luxeria/e-wall/README.md

e-wall
======

Steuerung e-wall

Die E-Wall ist eine Wand bestehend aus 12 Mainboards. 
Wenn Personen vor der Wand durchlaufen, soll darauf reagiert werden. 

Die Messung der Distanz erfolgt dabei über Ultraschall. 
Die Lüfter und LEDs werden mit einem Schieberegister angesteuert.
