luxeria/e-wall/doc/firmware.tex

% coding:utf-8

%E-Wall
%Copyright (C) 2013, Daniel Winz, Ervin Mazlagic

%This program is free software; you can redistribute it and/or
%modify it under the terms of the GNU General Public License
%as published by the Free Software Foundation; either version 2
%of the License, or (at your option) any later version.

%This program is distributed in the hope that it will be useful,
%but WITHOUT ANY WARRANTY; without even the implied warranty of
%MERCHANTABILITY or FITNESS FOR A PARTICULAR PURPOSE.  See the
%GNU General Public License for more details.
%----------------------------------------

\section{Firmware}

\subsection{Konzept}
Der Ultraschallsensor wird in regelmässigen Abständen ausgelesen. Die 
Zeitmessung erfolgt dabei durch einen Timer. Anschliessend werden die 
Ausgänge entsprechend der gemessenen Distanz gesetzt. Dabei werden 
grundsätzlich bei abnehmender Distanz mehr Ausgänge gesetzt. Die 
Ansteuerung der Schieberegister erfolgt dabei durch das SPI Modul. Nach der 
Übertragung werden die Schieberegister gesetzt. Anschliessend folgt die 
nächste Distanzmessung.
