luxeria/e-wall/hardware/LaunchPad_Standard20.png

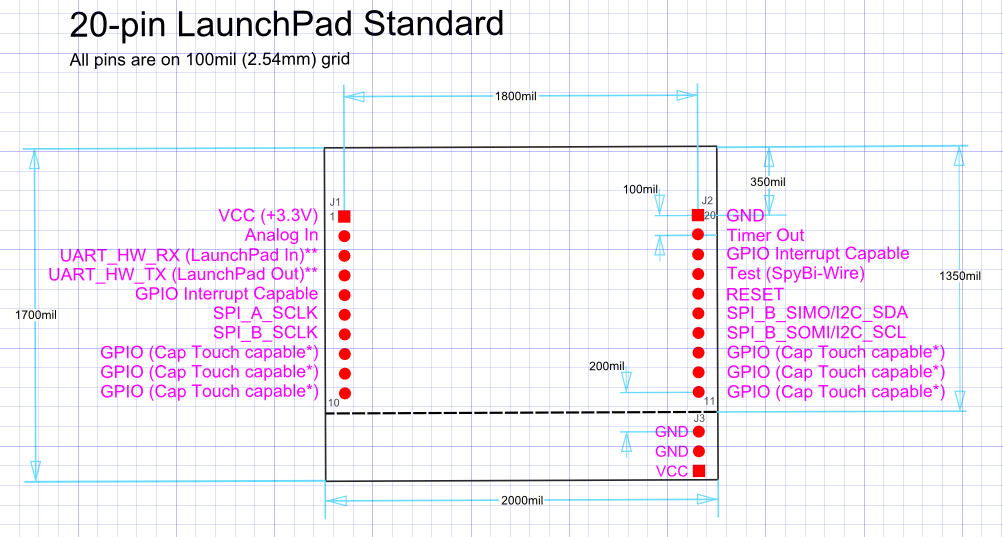
hardware/LaunchPad_Standard20.png
