luxeria/e-wall/hardware/e-wall-smd.brd

## EAGLE design hardware/e-wall-smd.brd (2015-08-02)

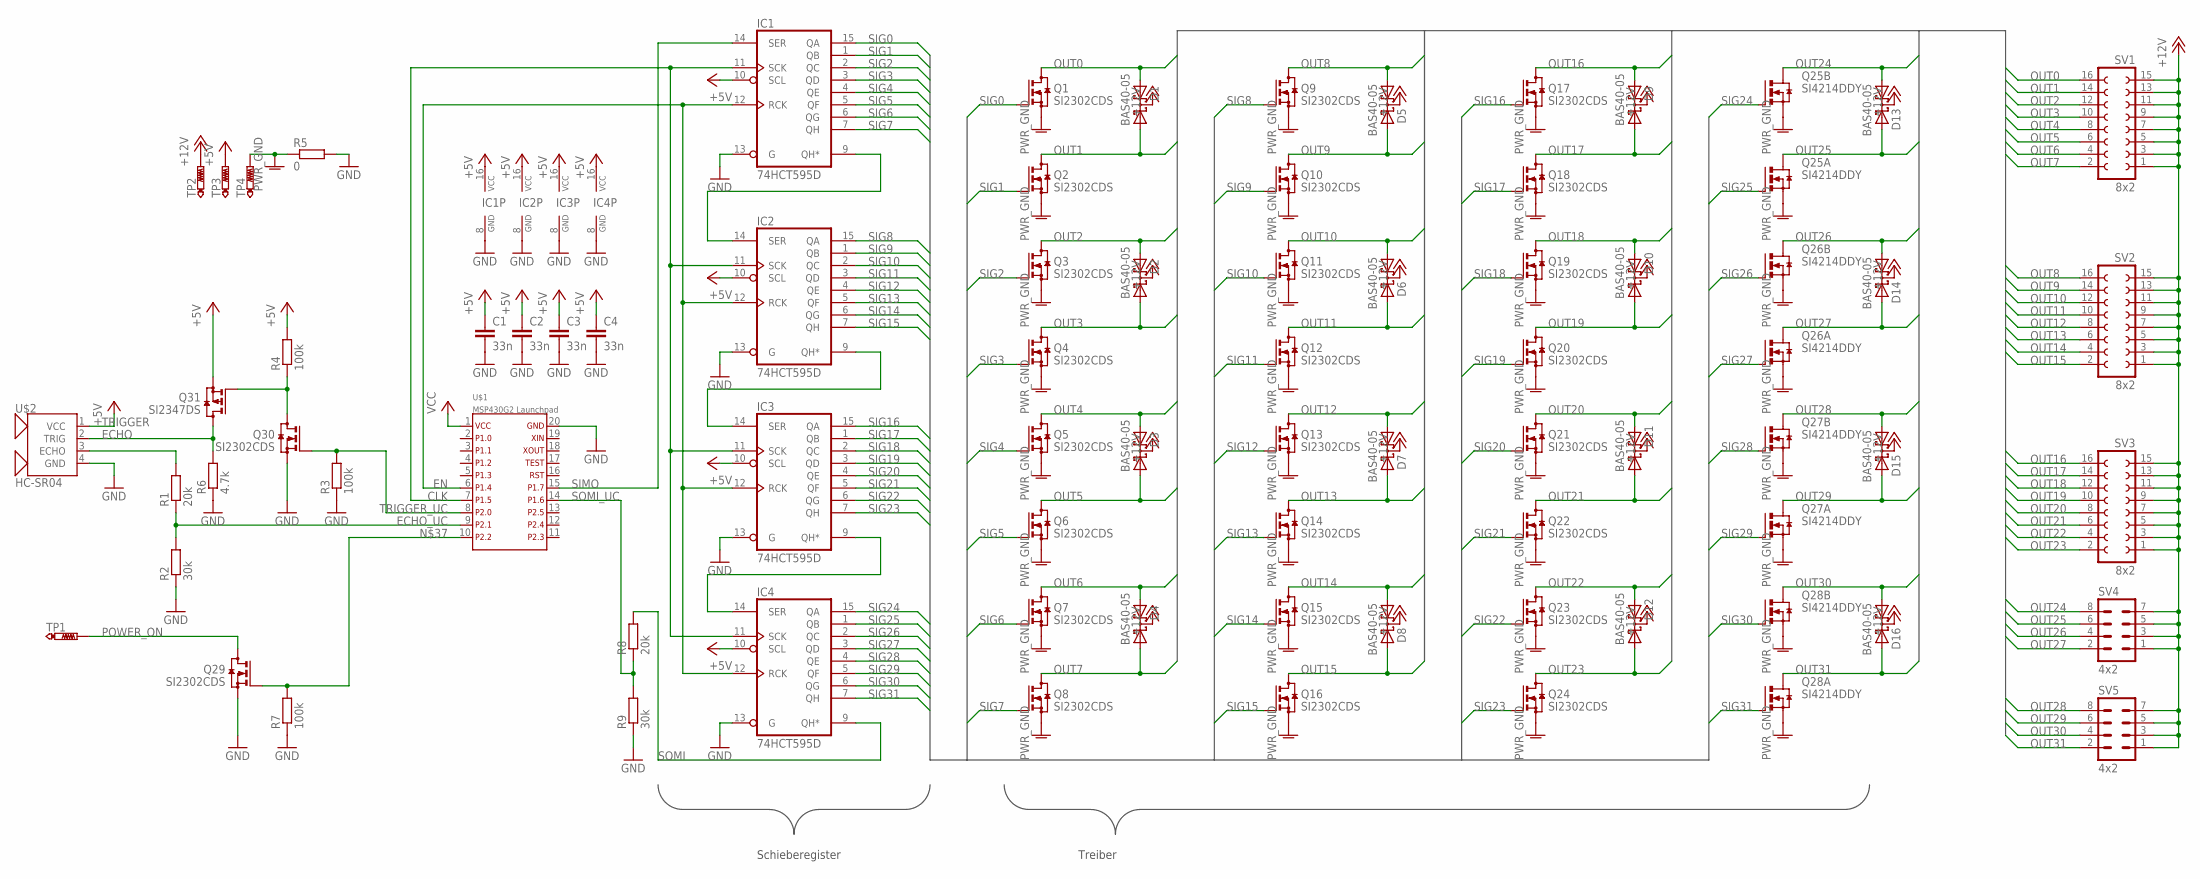
[picture p2: schematic e-wall-smd.sch]

Parts:
C1, C2, C3, C4: 33n; C1206
D1, D2, D3, D4, D5, D6, D7, D8, D9, D10, D11, D12, D13, D14, D15, D16: BAS40-05; SOT23
IC1, IC2, IC3, IC4: 74HCT595D; SO16
Q1, Q2, Q3, Q4, Q5, Q6, Q7, Q8, Q9, Q10, Q11, Q12, Q13, Q14, Q15, Q16, Q17, Q18, Q19, Q20, Q21, Q22, Q23, Q24, Q29, Q30: SI2302CDS; SOT23
Q25, Q26, Q27, Q28: SI4214DDY; SO-08
Q31: SI2347DS; SOT23
R1, R8: 20k; R1206
R2, R9: 30k; R1206
R3, R4, R7: 100k; R1206
R5: 0; R1206
R6: 4.7k; R1206
SV1, SV2, SV3: 8x2; FE08-2
SV4, SV5: 4x2; MA04-2
TP1, TP2, TP3, TP4: PTR1PAD1-20; P1-20
U$1: MSP430G2 Launchpad; MSP430LAUNCHPAD_BASIC
U$2: HC-SR04

Connections:
+5V: C1.1, C2.1, C3.1, C4.1, IC1.10 (SCL), IC1.16 (VCC), IC2.10 (SCL), IC2.16 (VCC), IC3.10 (SCL), IC3.16 (VCC), IC4.10 (SCL), IC4.16 (VCC), Q31.2 (S), R4.2, TP3.TP, U$2.1 (VCC)
+12V: D1.3 (C), D2.3 (C), D3.3 (C), D4.3 (C), D5.3 (C), D6.3 (C), D7.3 (C), D8.3 (C), D9.3 (C), D10.3 (C), D11.3 (C), D12.3 (C), D13.3 (C), D14.3 (C), D15.3 (C), D16.3 (C), SV1.1, SV1.3, SV1.5, SV1.7, SV1.9, SV1.11, SV1.13, SV1.15, SV2.1, SV2.3, SV2.5, SV2.7, SV2.9, SV2.11, SV2.13, SV2.15, SV3.1, SV3.3, SV3.5, SV3.7, SV3.9, SV3.11, SV3.13, SV3.15, SV4.1, SV4.3, SV4.5, SV4.7, SV5.1, SV5.3, SV5.5, SV5.7, TP2.TP
CLK: IC1.11 (SCK), IC2.11 (SCK), IC3.11 (SCK), IC4.11 (SCK), U$1.7
ECHO: R1.2, U$2.3 (ECHO)
ECHO_UC: R1.1, R2.2, U$1.9
EN: IC1.12 (RCK), IC2.12 (RCK), IC3.12 (RCK), IC4.12 (RCK), U$1.6
GND: C1.2, C2.2, C3.2, C4.2, IC1.8 (GND), IC1.13 (G), IC2.8 (GND), IC2.13 (G), IC3.8 (GND), IC3.13 (G), IC4.8 (GND), IC4.13 (G), Q29.2 (S), Q30.2 (S), R2.1, R3.1, R5.2, R6.1, R7.1, R9.1, U$1.20, U$2.4 (GND)
unnamed: IC1.9 (QH*), IC2.14 (SER)
unnamed: IC2.9 (QH*), IC3.14 (SER)
unnamed: IC3.9 (QH*), IC4.14 (SER)
unnamed: Q30.3 (D), Q31.1 (G), R4.1
unnamed: Q29.1 (G), R7.2, U$1.10
OUT0: D1.2 (A2), Q1.3 (D), SV1.16
OUT1: D1.1 (A1), Q2.3 (D), SV1.14
OUT2: D2.2 (A2), Q3.3 (D), SV1.12
OUT3: D2.1 (A1), Q4.3 (D), SV1.10
OUT4: D3.2 (A2), Q5.3 (D), SV1.8
OUT5: D3.1 (A1), Q6.3 (D), SV1.6
OUT6: D4.2 (A2), Q7.3 (D), SV1.4
OUT7: D4.1 (A1), Q8.3 (D), SV1.2
OUT8: D5.1 (A1), Q9.3 (D), SV2.16
OUT9: D5.2 (A2), Q10.3 (D), SV2.14
OUT10: D6.1 (A1), Q11.3 (D), SV2.12
OUT11: D6.2 (A2), Q12.3 (D), SV2.10
OUT12: D7.1 (A1), Q13.3 (D), SV2.8
OUT13: D7.2 (A2), Q14.3 (D), SV2.6
OUT14: D8.1 (A1), Q15.3 (D), SV2.4
OUT15: D8.2 (A2), Q16.3 (D), SV2.2
OUT16: D9.2 (A2), Q17.3 (D), SV3.16
OUT17: D9.1 (A1), Q18.3 (D), SV3.14
OUT18: D10.2 (A2), Q19.3 (D), SV3.12
OUT19: D10.1 (A1), Q20.3 (D), SV3.10
OUT20: D11.2 (A2), Q21.3 (D), SV3.8
OUT21: D11.1 (A1), Q22.3 (D), SV3.6
OUT22: D12.2 (A2), Q23.3 (D), SV3.4
OUT23: D12.1 (A1), Q24.3 (D), SV3.2
OUT24: D13.1 (A1), Q25.7 (D), Q25.8 (D), SV4.8
OUT25: D13.2 (A2), Q25.5 (D), Q25.6 (D), SV4.6
OUT26: D14.1 (A1), Q26.7 (D), Q26.8 (D), SV4.4
OUT27: D14.2 (A2), Q26.5 (D), Q26.6 (D), SV4.2
OUT28: D15.1 (A1), Q27.7 (D), Q27.8 (D), SV5.8
OUT29: D15.2 (A2), Q27.5 (D), Q27.6 (D), SV5.6
OUT30: D16.1 (A1), Q28.7 (D), Q28.8 (D), SV5.4
OUT31: D16.2 (A2), Q28.5 (D), Q28.6 (D), SV5.2
POWER_ON: Q29.3 (D), TP1.TP
PWR_GND: Q1.2 (S), Q2.2 (S), Q3.2 (S), Q4.2 (S), Q5.2 (S), Q6.2 (S), Q7.2 (S), Q8.2 (S), Q9.2 (S), Q10.2 (S), Q11.2 (S), Q12.2 (S), Q13.2 (S), Q14.2 (S), Q15.2 (S), Q16.2 (S), Q17.2 (S), Q18.2 (S), Q19.2 (S), Q20.2 (S), Q21.2 (S), Q22.2 (S), Q23.2 (S), Q24.2 (S), Q25.1 (S), Q25.3 (S), Q26.1 (S), Q26.3 (S), Q27.1 (S), Q27.3 (S), Q28.1 (S), Q28.3 (S), R5.1, TP4.TP
SIG0: IC1.15 (QA), Q1.1 (G)
SIG1: IC1.1 (QB), Q2.1 (G)
SIG2: IC1.2 (QC), Q3.1 (G)
SIG3: IC1.3 (QD), Q4.1 (G)
SIG4: IC1.4 (QE), Q5.1 (G)
SIG5: IC1.5 (QF), Q6.1 (G)
SIG6: IC1.6 (QG), Q7.1 (G)
SIG7: IC1.7 (QH), Q8.1 (G)
SIG8: IC2.15 (QA), Q9.1 (G)
SIG9: IC2.1 (QB), Q10.1 (G)
SIG10: IC2.2 (QC), Q11.1 (G)
SIG11: IC2.3 (QD), Q12.1 (G)
SIG12: IC2.4 (QE), Q13.1 (G)
SIG13: IC2.5 (QF), Q14.1 (G)
SIG14: IC2.6 (QG), Q15.1 (G)
SIG15: IC2.7 (QH), Q16.1 (G)
SIG16: IC3.15 (QA), Q17.1 (G)
SIG17: IC3.1 (QB), Q18.1 (G)
SIG18: IC3.2 (QC), Q19.1 (G)
SIG19: IC3.3 (QD), Q20.1 (G)
SIG20: IC3.4 (QE), Q21.1 (G)
SIG21: IC3.5 (QF), Q22.1 (G)
SIG22: IC3.6 (QG), Q23.1 (G)
SIG23: IC3.7 (QH), Q24.1 (G)
SIG24: IC4.15 (QA), Q25.2 (G)
SIG25: IC4.1 (QB), Q25.4 (G)
SIG26: IC4.2 (QC), Q26.2 (G)
SIG27: IC4.3 (QD), Q26.4 (G)
SIG28: IC4.4 (QE), Q27.2 (G)
SIG29: IC4.5 (QF), Q27.4 (G)
SIG30: IC4.6 (QG), Q28.2 (G)
SIG31: IC4.7 (QH), Q28.4 (G)
SIMO: IC1.14 (SER), U$1.15
SOMI: IC4.9 (QH*), R8.2
SOMI_UC: R8.1, R9.2, U$1.14
TRIGGER: Q31.3 (D), R6.2, U$2.2 (TRIG)
TRIGGER_UC: Q30.1 (G), R3.2, U$1.8
VCC: U$1.1

Notes on the sheet:
Treiber
Schieberegister

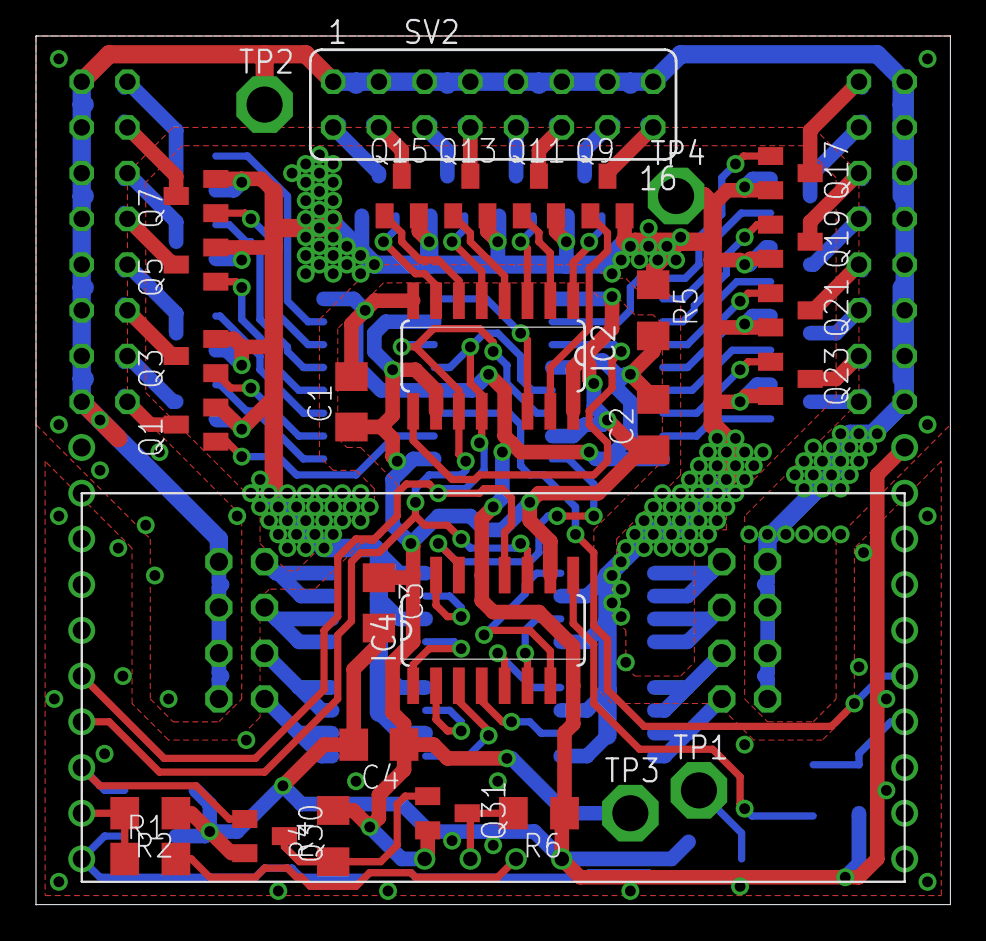
[picture p3: board e-wall-smd.brd from above]

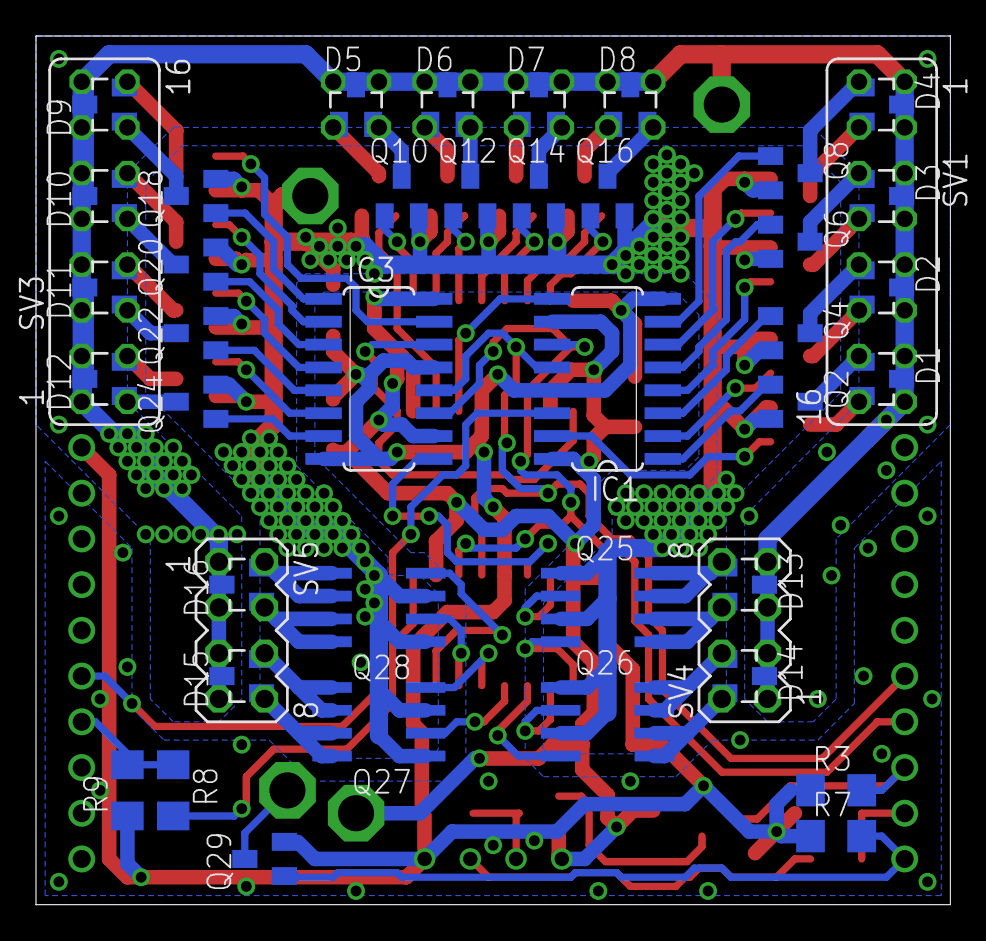
[picture p4: board e-wall-smd.brd from below]

Board: 2 copper layers, 50.8 x 48.3 mm, 75 parts (43 on the bottom side), 83 nets.
