luxeria/e-wall/hardware/e-wall.brd

## EAGLE design hardware/e-wall.brd (2014-07-15)

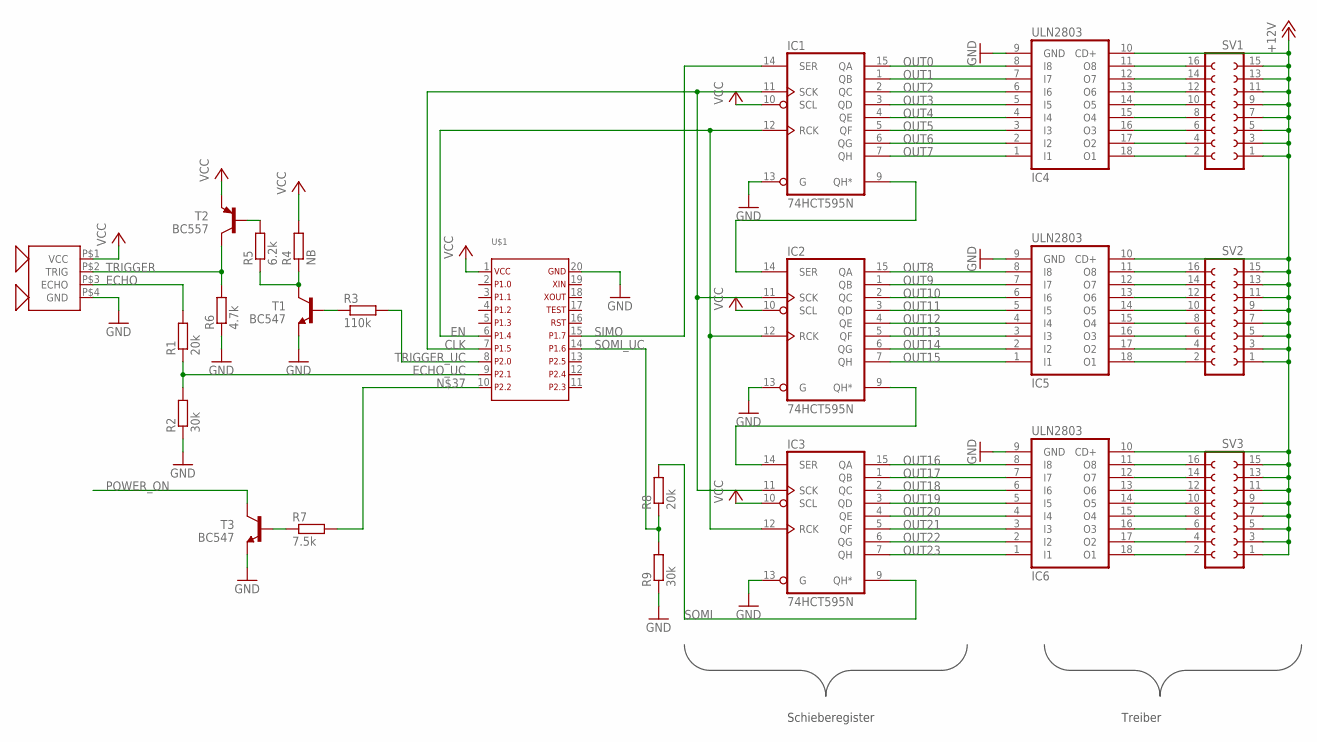
[picture p5: schematic e-wall.sch]

Parts:
IC1, IC2, IC3: 74HCT595N; DIL16
IC4, IC5, IC6: ULN2803; DIL18
R1, R8: 20k; 0207/7
R2, R9: 30k; 0207/7
R3: 110k; 0207/7
R4: NB; 0207/2V
R5: 6.2k; 0207/2V
R6: 4.7k; 0207/7
R7: 7.5k; 0207/7
SV1, SV2, SV3: FE08-2
T1, T3: BC547; TO92-EBC
T2: BC557; TO92-BEC
U$1: MSP430LAUNCHPAD_BASIC
U$2: HC-SR04

Connections:
+12V: IC4.10 (CD+), IC5.10 (CD+), IC6.10 (CD+), SV1.1, SV1.3, SV1.5, SV1.7, SV1.9, SV1.11, SV1.13, SV1.15, SV2.1, SV2.3, SV2.5, SV2.7, SV2.9, SV2.11, SV2.13, SV2.15, SV3.1, SV3.3, SV3.5, SV3.7, SV3.9, SV3.11, SV3.13, SV3.15
CLK: IC1.11 (SCK), IC2.11 (SCK), IC3.11 (SCK), U$1.7
ECHO: R1.2, U$2.P$3 (ECHO)
ECHO_UC: R1.1, R2.2, U$1.9
EN: IC1.12 (RCK), IC2.12 (RCK), IC3.12 (RCK), U$1.6
GND: IC1.8 (GND), IC1.13 (G), IC2.8 (GND), IC2.13 (G), IC3.8 (GND), IC3.13 (G), IC4.9 (GND), IC5.9 (GND), IC6.9 (GND), R2.1, R6.1, R9.1, T1.E, T3.E, U$1.20, U$2.P$4 (GND)
unnamed: IC1.9 (QH*), IC2.14 (SER)
unnamed: IC2.9 (QH*), IC3.14 (SER)
unnamed: IC6.18 (O1), SV3.2
unnamed: IC6.17 (O2), SV3.4
unnamed: IC6.16 (O3), SV3.6
unnamed: IC6.15 (O4), SV3.8
unnamed: IC6.14 (O5), SV3.10
unnamed: IC6.13 (O6), SV3.12
unnamed: IC6.12 (O7), SV3.14
unnamed: IC6.11 (O8), SV3.16
unnamed: IC5.18 (O1), SV2.2
unnamed: IC5.17 (O2), SV2.4
unnamed: IC5.16 (O3), SV2.6
unnamed: IC5.15 (O4), SV2.8
unnamed: IC5.14 (O5), SV2.10
unnamed: IC5.13 (O6), SV2.12
unnamed: IC5.12 (O7), SV2.14
unnamed: IC5.11 (O8), SV2.16
unnamed: IC4.18 (O1), SV1.2
unnamed: IC4.17 (O2), SV1.4
unnamed: IC4.16 (O3), SV1.6
unnamed: IC4.15 (O4), SV1.8
unnamed: IC4.14 (O5), SV1.10
unnamed: IC4.13 (O6), SV1.12
unnamed: IC4.12 (O7), SV1.14
unnamed: IC4.11 (O8), SV1.16
unnamed: R3.1, T1.B
unnamed: R4.1, R5.1, T1.C
unnamed: R5.2, T2.B
unnamed: R7.1, T3.B
unnamed: R7.2, U$1.10
OUT0: IC1.15 (QA), IC4.8 (I8)
OUT1: IC1.1 (QB), IC4.7 (I7)
OUT2: IC1.2 (QC), IC4.6 (I6)
OUT3: IC1.3 (QD), IC4.5 (I5)
OUT4: IC1.4 (QE), IC4.4 (I4)
OUT5: IC1.5 (QF), IC4.3 (I3)
OUT6: IC1.6 (QG), IC4.2 (I2)
OUT7: IC1.7 (QH), IC4.1 (I1)
OUT8: IC2.15 (QA), IC5.8 (I8)
OUT9: IC2.1 (QB), IC5.7 (I7)
OUT10: IC2.2 (QC), IC5.6 (I6)
OUT11: IC2.3 (QD), IC5.5 (I5)
OUT12: IC2.4 (QE), IC5.4 (I4)
OUT13: IC2.5 (QF), IC5.3 (I3)
OUT14: IC2.6 (QG), IC5.2 (I2)
OUT15: IC2.7 (QH), IC5.1 (I1)
OUT16: IC3.15 (QA), IC6.8 (I8)
OUT17: IC3.1 (QB), IC6.7 (I7)
OUT18: IC3.2 (QC), IC6.6 (I6)
OUT19: IC3.3 (QD), IC6.5 (I5)
OUT20: IC3.4 (QE), IC6.4 (I4)
OUT21: IC3.5 (QF), IC6.3 (I3)
OUT22: IC3.6 (QG), IC6.2 (I2)
OUT23: IC3.7 (QH), IC6.1 (I1)
POWER_ON: T3.C
SIMO: IC1.14 (SER), U$1.15
SOMI: IC3.9 (QH*), R8.2
SOMI_UC: R8.1, R9.2, U$1.14
TRIGGER: R6.2, T2.C, U$2.P$2 (TRIG)
TRIGGER_UC: R3.2, U$1.8
VCC: IC1.10 (SCL), IC1.16 (VCC), IC2.10 (SCL), IC2.16 (VCC), IC3.10 (SCL), IC3.16 (VCC), R4.2, T2.E, U$1.1, U$2.P$1 (VCC)

Notes on the sheet:
Treiber
Schieberegister

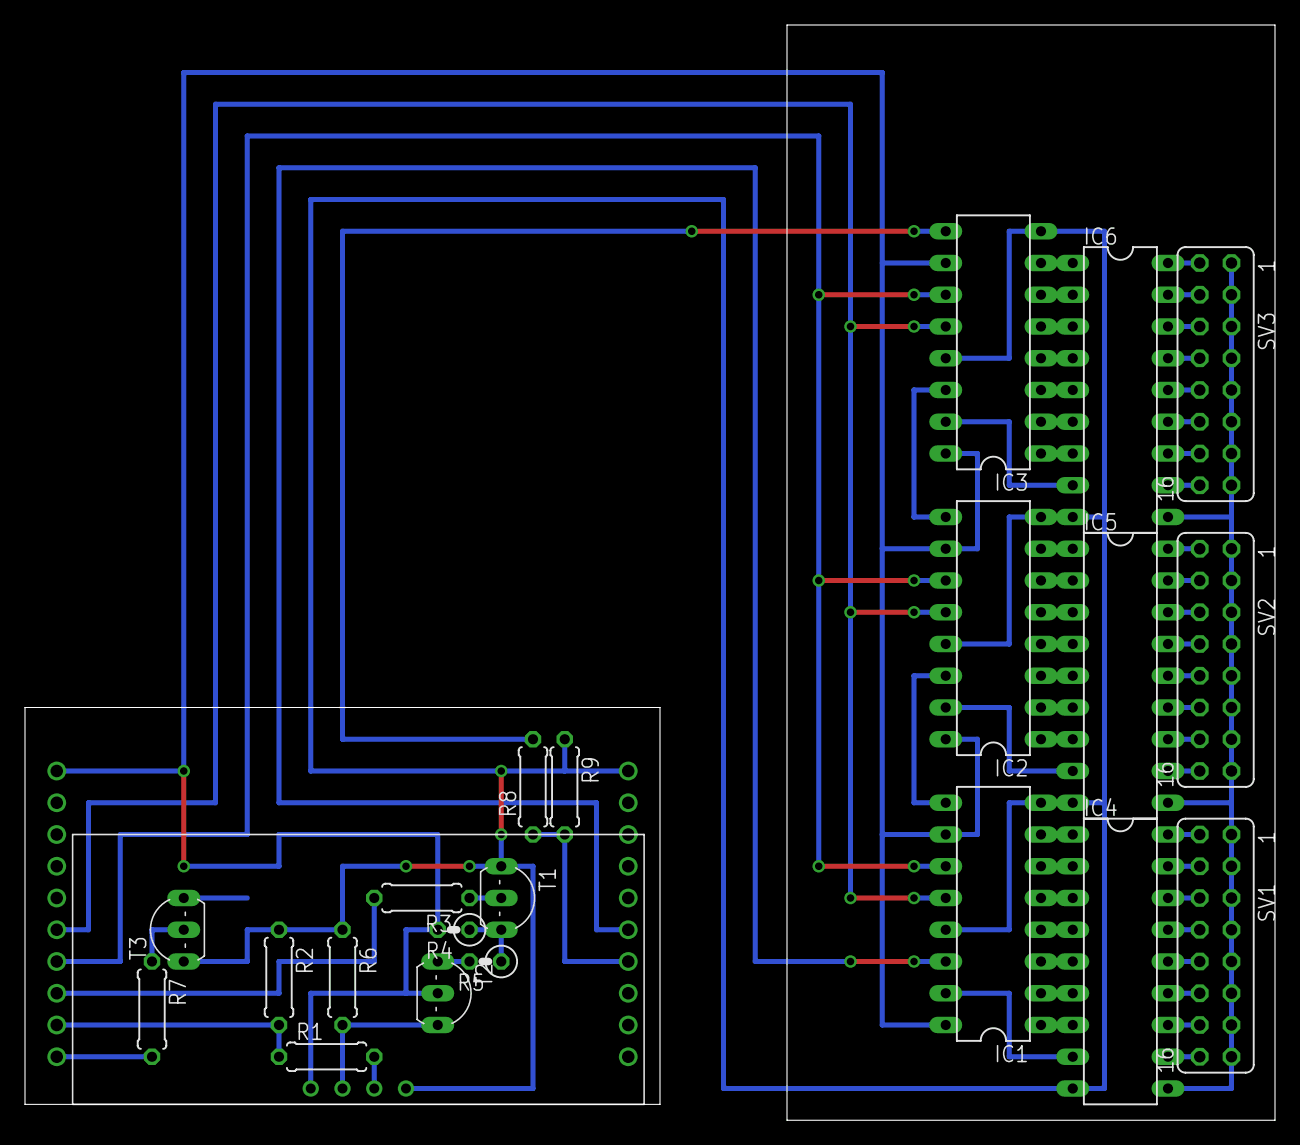
[picture p6: board e-wall.brd from above]

Board: 2 copper layers, 100.0 x 87.6 mm, 23 parts (0 on the bottom side), 67 nets.
