luxeria/e-wall/(commit log)

2013-07-27 Schema angefangen
    [e-wall.sch]
2013-07-29 LED und Lüfter im Blockschaltbild ergänzt
2013-07-30 label und caption zum Timingdiagramm hinzugefügt
2013-07-31 Deteilkonzept Ansteuerung Lüfter / LED
2013-07-31 Ergänzung zu Detailkonzept Ansteuerung Lüfter / LED
2013-08-06 Schieberegister für LEDs und Lüfter
    [e-wall.sch]
2013-08-07 Technologie der Schieberegister von 74HC zu 74HCT geändert
    [e-wall.sch]
2013-08-09 Treiber für LED und Lüfter
    [e-wall.sch]
2013-08-09 Blöcke angeschrieben
    [e-wall.sch]
2013-08-10 Pegelwandler für Ultraschallsensor gezeichnet, aber noch nicht dimensioniert
    [e-wall.sch]
2013-08-12 Pegelwandler in der Dokumentation ergänzt
2013-08-12 Pegelwandler mit zwei Transistoren
    [e-wall.sch]
2013-08-19 Launchpad angeschrieben
    [e-wall.sch]
2013-08-22 Werte für Spannungsteiler
    [e-wall.sch]
2013-08-23 Pegelwandler für Trigger korrigiert
    [e-wall.sch]
2013-08-24 Bauteilwerte Pegelwandler Trigger
    [e-wall.sch]
2013-08-24 Datenblatt und Family Guide MSP430G2553
2013-08-26 Transistoren beschriftet
    [e-wall.sch]
2013-08-27 Pin Initialisierung für Echo korrigiert
    [hardware.h]
2013-08-29 Temporäre Dateien des mspgcc im .gitignore eingetragen
2013-08-30 Schaltung Netzteileinschaltung
    [e-wall.sch]
2013-08-31 Einschaltung der Speisung in der Doku ergänzt
2014-04-21 Transistoren BSS123 durch Transistorarrays ULN2803 ersetzt
    [e-wall.sch]
2014-04-21 Datenblätter der Bipolartransistoren
2014-04-22 SMD Bauteile durch THT ersetzt
    [e-wall.sch]
2014-04-22 Layout erstellt
    [e-wall.brd]
2014-07-08 Spannungsteiler für SOMI
    [e-wall.brd, e-wall.sch]
2014-07-09 Ultraschallsensor eingebaut
    [e-wall.brd, e-wall.sch]
2014-07-10 Package der Widerstände geändert
    [e-wall.brd, e-wall.sch]
2014-07-10 SMD Version
    [e-wall-smd.brd, e-wall-smd.sch]
2014-07-10 Freilaufdiode ergänzt
    [e-wall-smd.brd, e-wall-smd.sch]
2014-07-11 Schieberegister verschoben
    [e-wall-smd.brd, e-wall-smd.sch]
2014-07-15 Leitungen für SPI umbenannt
    [e-wall-smd.brd, e-wall-smd.sch, e-wall.brd, e-wall.sch]
2014-07-18 Zusätzliches Schieberegister mit Treiber für mehr Strom
    [e-wall-smd.brd, e-wall-smd.sch]
2014-07-18 Anschlüsse für Versorgung und Kupferflächen für MAsse und 12V
    [e-wall-smd.brd, e-wall-smd.sch]
2014-07-20 Kleine anpassungen im Layout
    [e-wall-smd.brd]
2014-07-28 Pegelwandler mit FET
    [e-wall-smd.brd, e-wall-smd.sch]
2014-07-28 Transistortypen festgelegt
    [e-wall-smd.brd, e-wall-smd.sch]
2014-07-29 kleine Anpassungen im Schema, erc bereinigt
    [e-wall-smd.brd, e-wall-smd.sch]
2014-07-30 Kondensatoren ergänzt
    [e-wall-smd.brd, e-wall-smd.sch]
2014-07-30 Freilaufdioden bei Hochstromausgängen
    [e-wall-smd.brd, e-wall-smd.sch]
2014-07-31 Design Rules von Platinensammler angewendet
    [e-wall-smd.brd, e-wall-smd.sch]
2014-09-02 Some typedefs and function prototypes
2014-09-16 state machine for ultrasonic measurement
2014-09-28 Some work on isr for ultrasonic module
2014-10-15 polygons prepared for additional cpooer wire
    [e-wall-smd.brd]
2014-10-16 moved some tracers to avoid layer change of high current paths
    [e-wall-smd.brd, e-wall-smd.sch]
2014-10-18 Separate polygons for signal and power ground
    [e-wall-smd.brd, e-wall-smd.sch]
2014-10-20 Polygons for adding copper wire to increase maximal current
    [e-wall-smd.brd]
2014-11-12 OSHW Logo
    [e-wall-smd.brd]
2014-11-12 Connections labled
    [e-wall-smd.brd]
2014-11-13 kleine Änderungen am Layout
    [e-wall-smd.brd, e-wall-smd.sch]
2014-11-18 Small changes in ultrasonic
